HaoranLi-Data/Tactile_SoftHand_A/CAD_Models/Tactile_fingertip_for_3D_Printing.stp

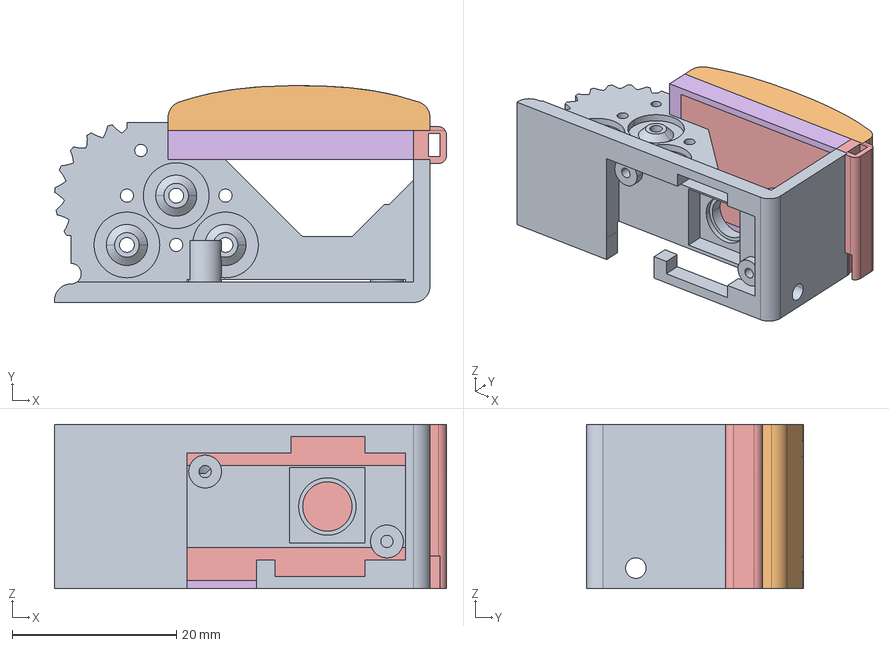
[picture p2: CAD file, 2025-09-21]
CAD_Models/Tactile_fingertip_for_3D_Printing.stp
47.7 x 26.4 x 20.0 mm
fingertip_skeleton
Fingertip_skin_surfacev4
Fingertip_marker_v4
Fingertip_soft_clear_v4
Tactile_fingertip_lens_v4
black_cover
