HaoranLi-Data/Tactile_SoftHand_A/CAD_Models/softfinger with tactile fingertip.stp

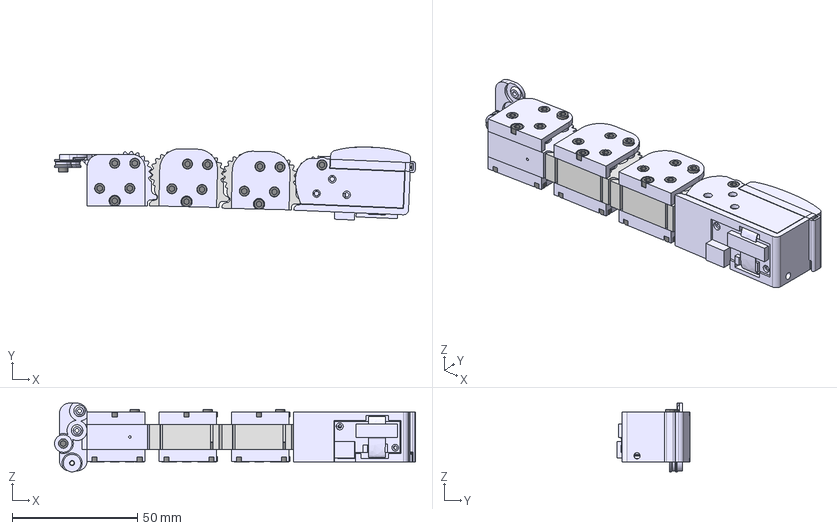
[picture p3: CAD file, 2025-09-21]
CAD_Models/softfinger with tactile fingertip.stp
143.8 x 29.1 x 27.4 mm
M2x6BOLT.1 x 18
M2x6BOLT.1.1.1 x 6
BearingD7W3 x 25
hand_v2_mid_cover_mirrorside.1.1 x 2
base cover 2 x 2
base phalange with AA
base_cover_mirrorside.1.1.1
M2x6BOLT.1.1 x 14
base_cover_mirrorside.1
fingertip_skeleton
fingertip_camera_board
fingertip_camera
fingertip_camera_lens
Fingertip_skin_surfacev4
Fingertip_marker_v4
Fingertip_soft_clear_v4
Tactile_fingertip_lens_v4
black_cover
Fingertip_cover_right
Fingertip_cover_left
AA_Tactile_fingertip_led_strip
phalange_connector 16.8 x 3
