HaoranLi-Data/Tactile_SoftHand_A/(list of files, cad)

Other CAD files:
CAD_Models/softfinger without tactile fingertip.stp
