HaoranLi-Data/Tactile_SoftHand_A/Manufacturing_instructions/3D_Printing_instruction_for_tactile_fingertip.md

Equipment requirement: Stratasys J826 printer

material selection for
