HaoranLi-Data/Tactile_SoftHand_A/(commit log)

2025-09-21 added more materials
    [finger_with_tactile_fingertip.stp]
2025-09-21 add material
2025-11-19 Add files via upload
    D-type finger: modified the fingertip CAD model by adding the groove for elastic bands
    [D type softfinger with Active Antagonism.stp]
